soggybag/Tri-Fuzz/docs/variant_schematic.gif

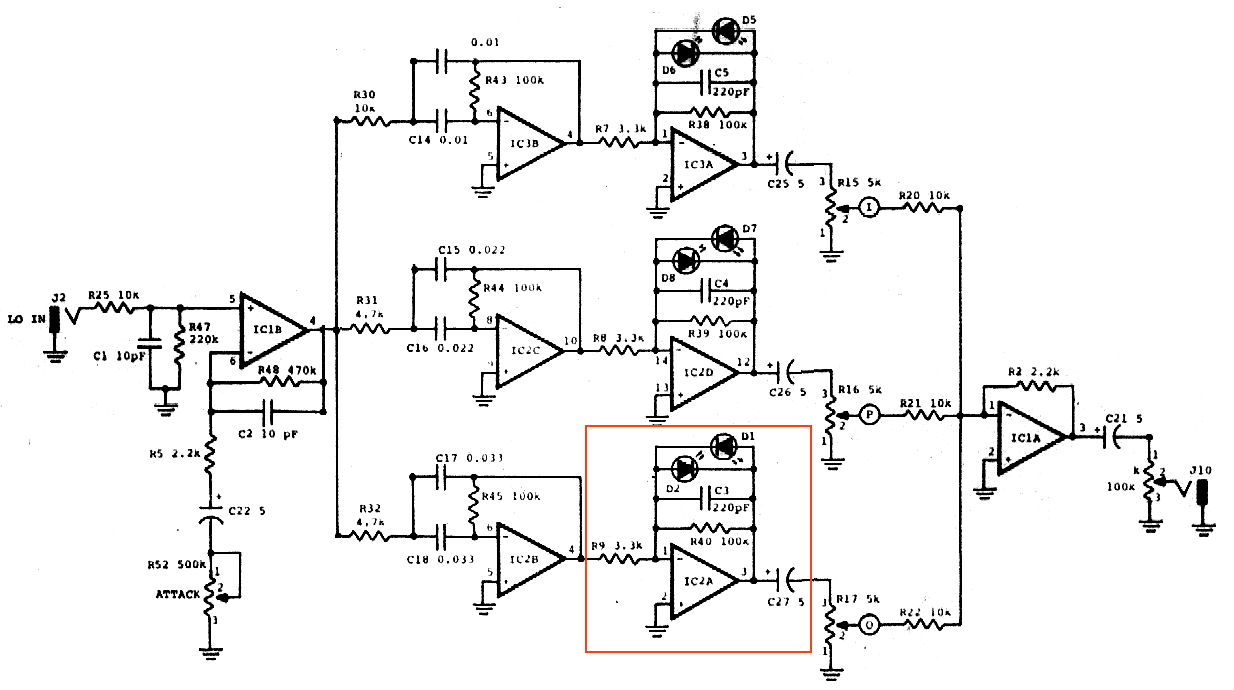
docs/variant_schematic.gif
