soggybag/Tri-Fuzz/docs/TriFuzz_schematic.pdf

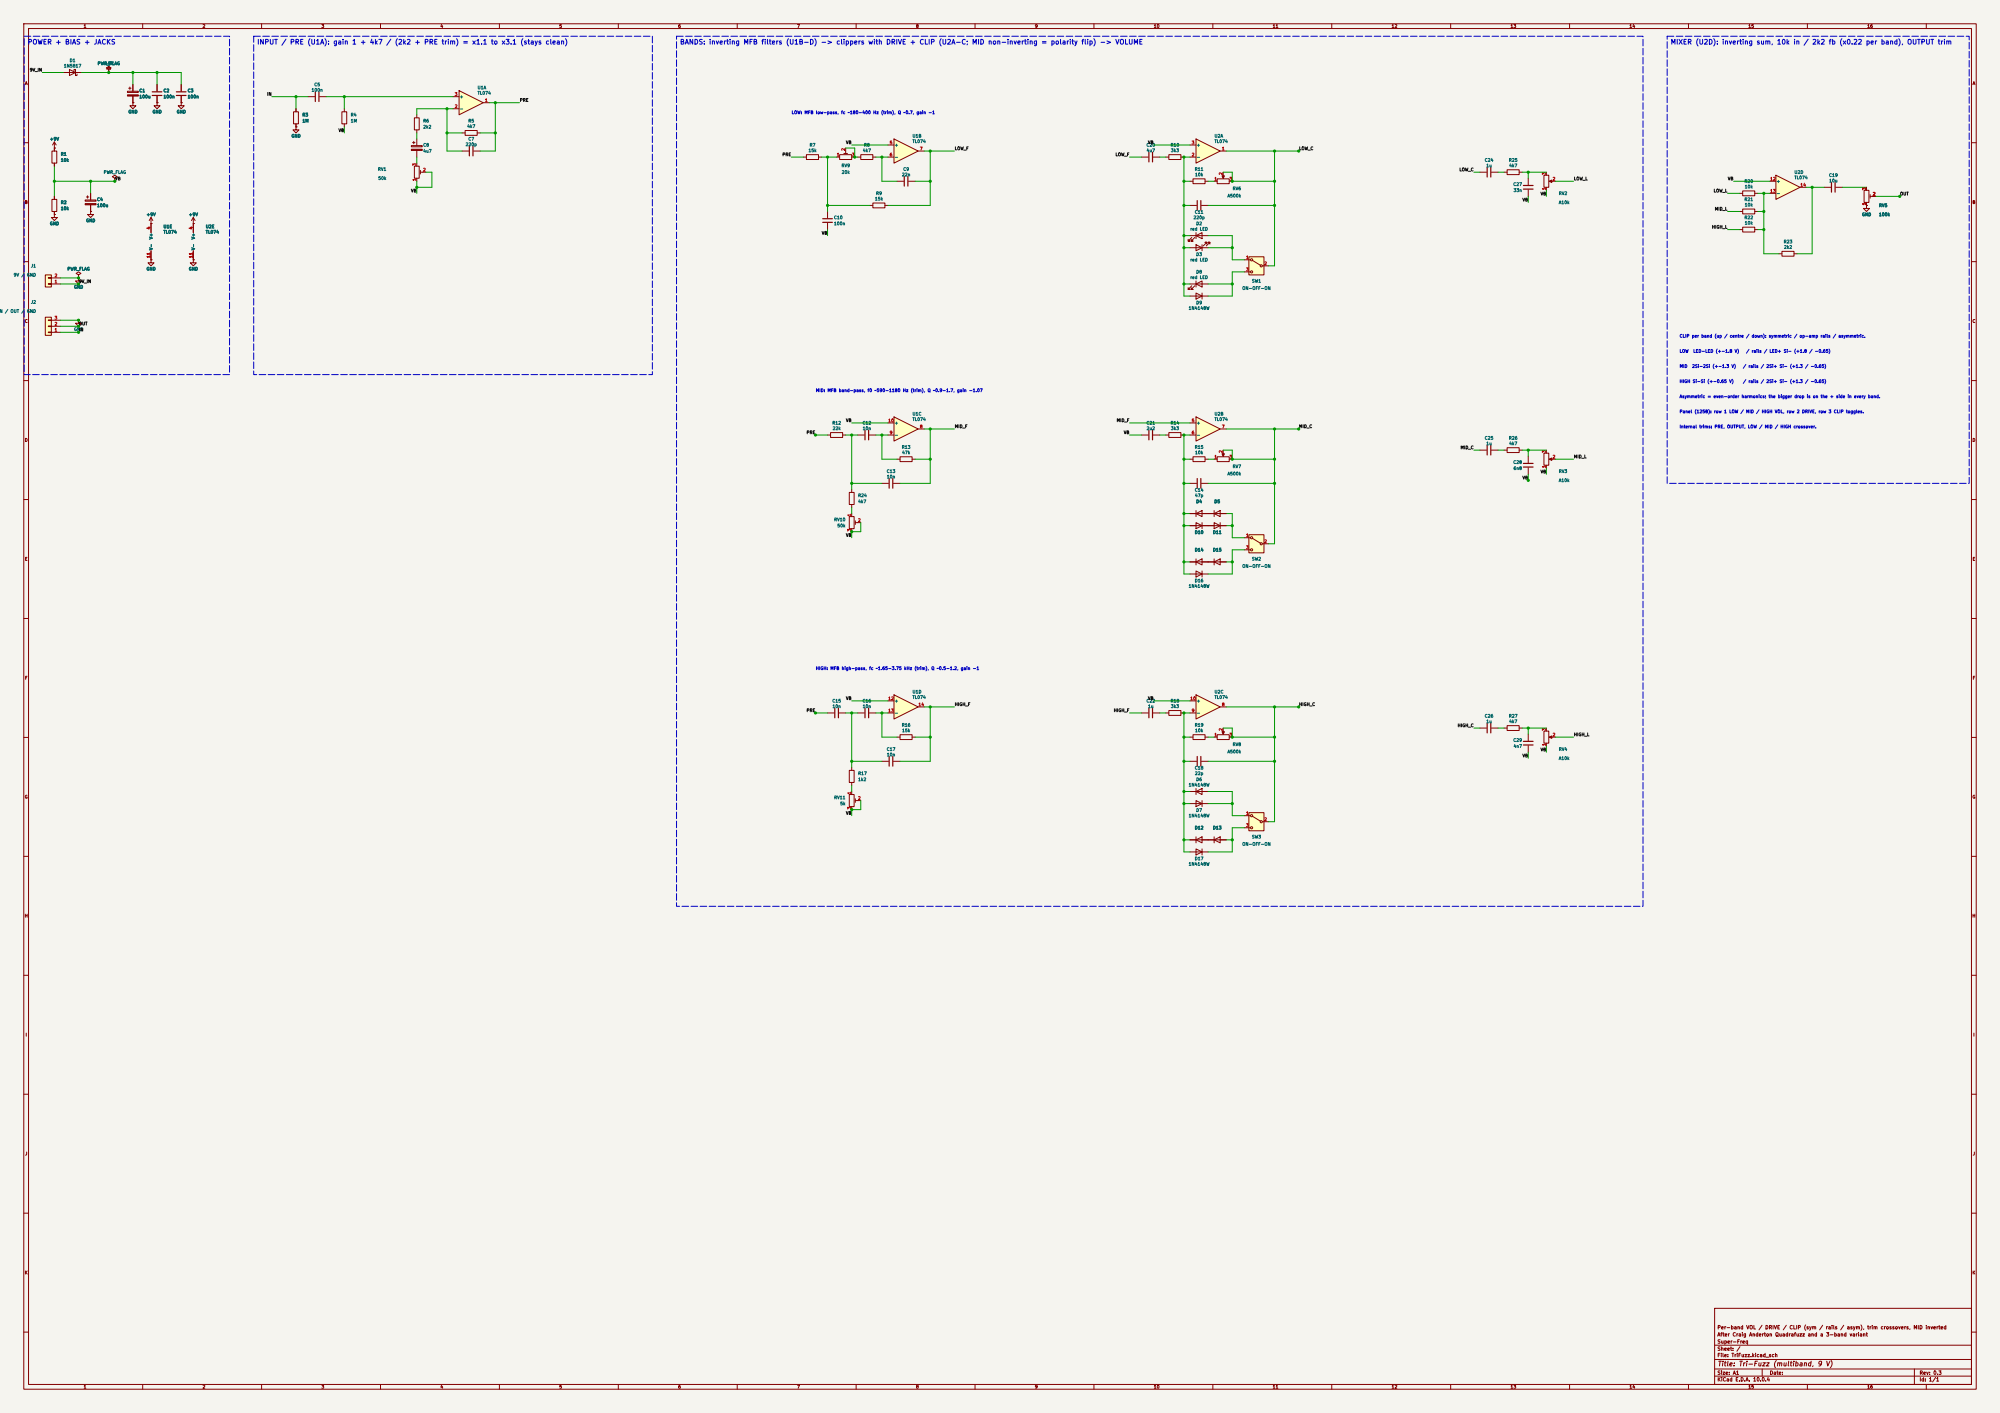
[picture p2: page 1]

BANDS: inverting MFB filters (U1B-D) -> clippers with DRIVE + CLIP (U2A-C; MID non-inverting = polarity flip) -> VOLUME

LOW: MFB low-pass, fc ~180-400 Hz (trim), Q ~0.7, gain -1

MID: MFB band-pass, f0 ~590-1180 Hz (trim), Q ~0.9-1.7, gain -1.07

Internal trims: PRE, OUTPUT, LOW / MID / HIGH crossover. Panel (125B): row 1 LOW / MID / HIGH VOL, row 2 DRIVE, row 3 CLIP toggles.

Per-band VOL / DRIVE / CLIP (sym / rails / asym), trim crossovers, MID inverted
After Craig Anderton Quadrafuzz and a 3-band variant
Super-Freq
Sheet: /
File: TriFuzz.kicad_sch
Title: Tri-Fuzz (multiband, 9 V)

Size: A1 | Rev: 0.3
KiCad E.D.A. 10.0.4 | Id: 1/1
