soggybag/Tri-Fuzz/archive/v0.1/TriFuzz_schematic_v0.1.pdf

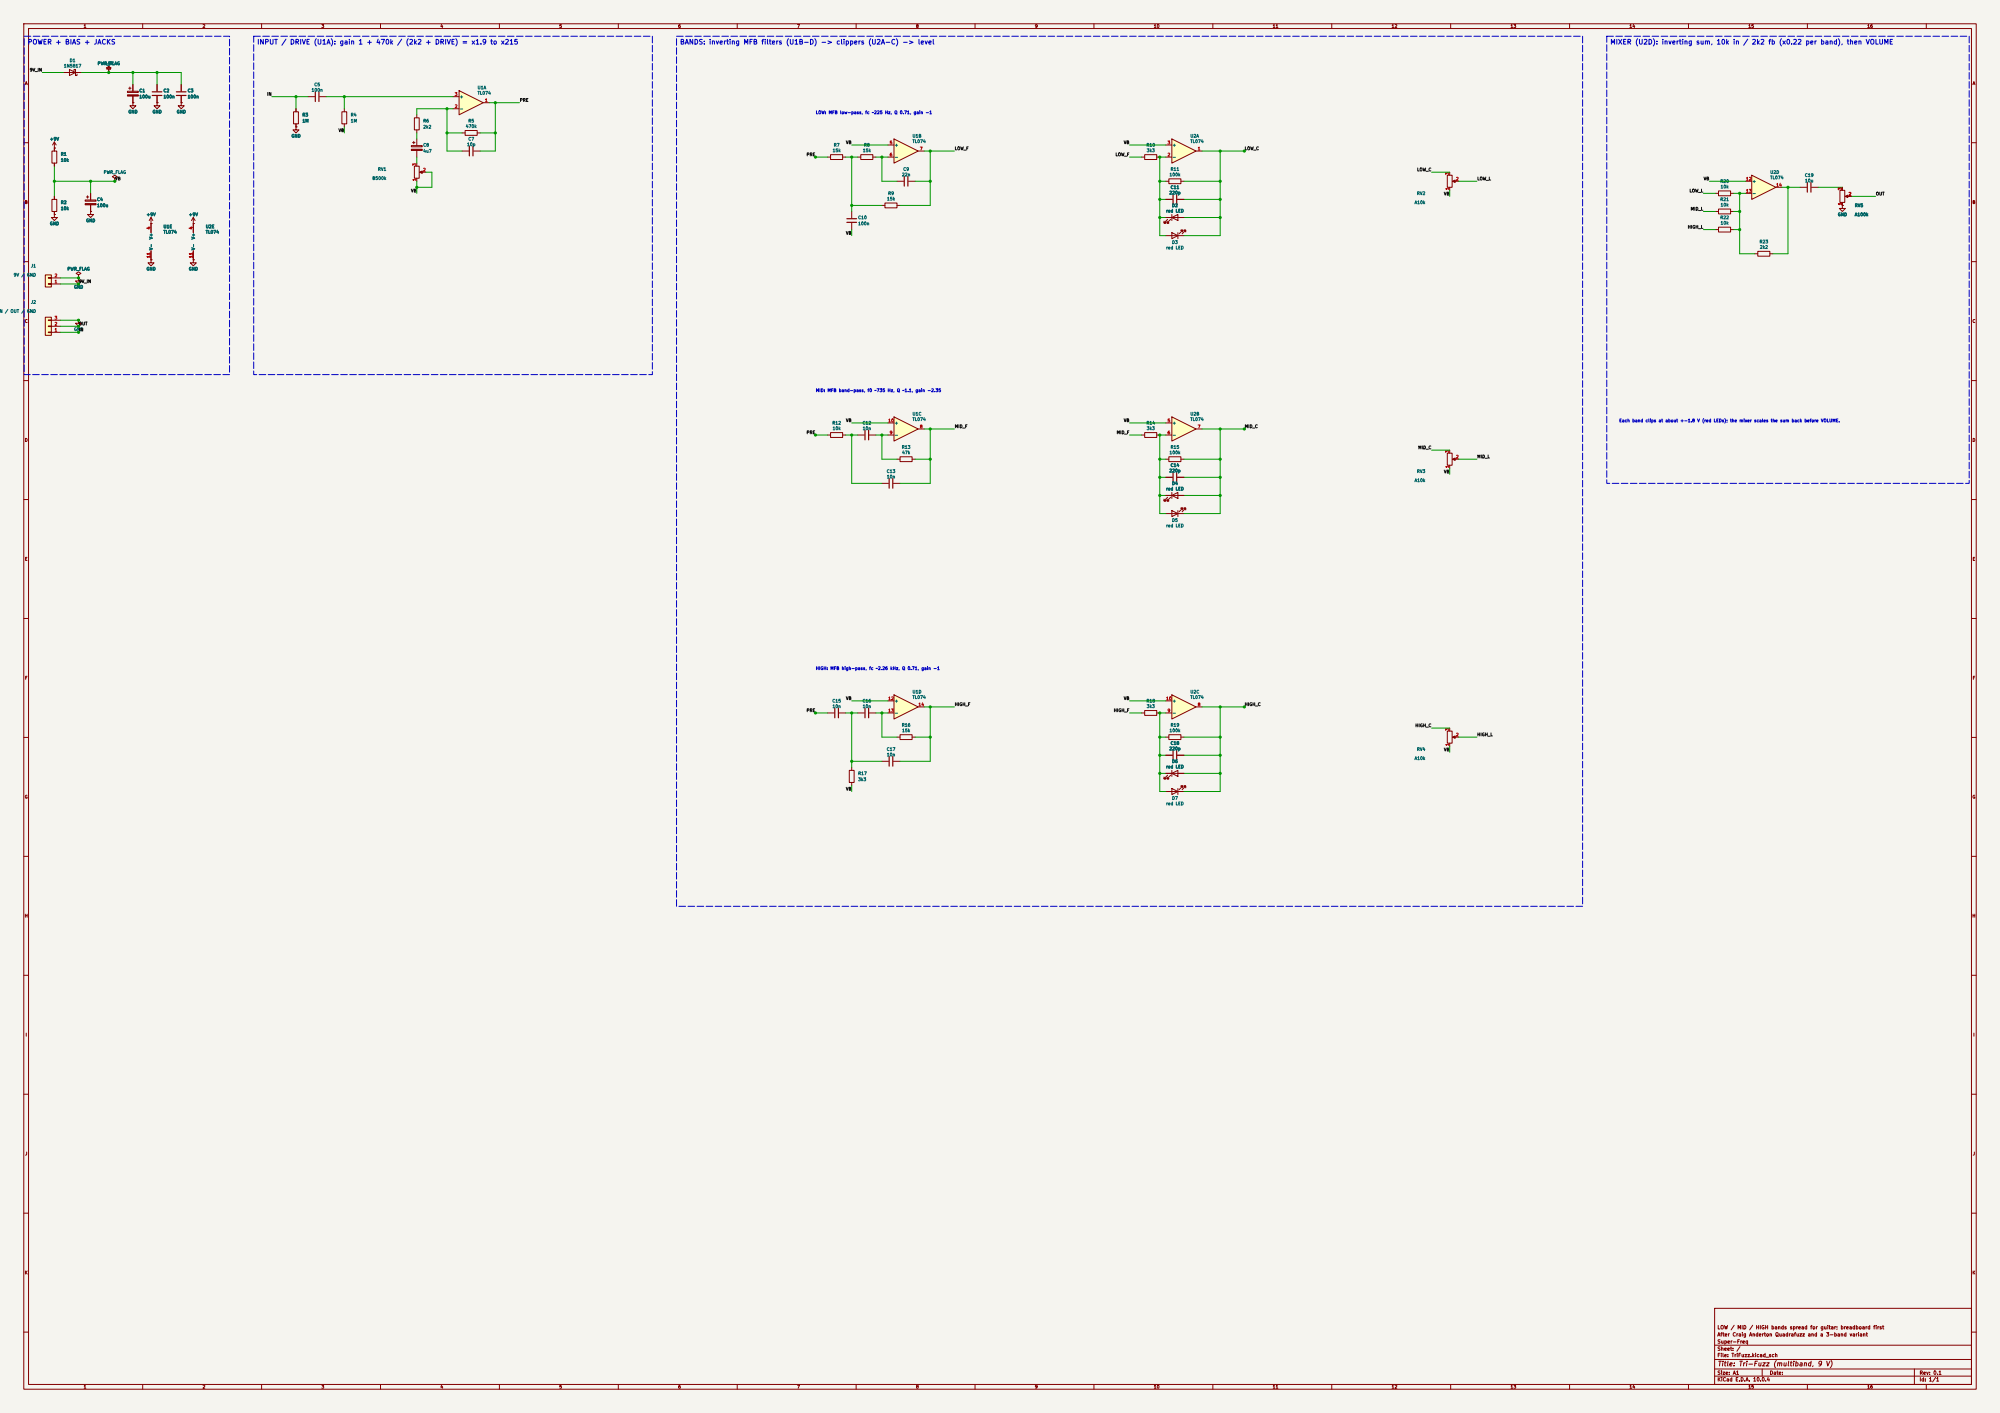
[picture p3: page 1]

INPUT / DRIVE (U1A): gain 1 + 470k / (2k2 + DRIVE) = x1.9 to x215

BANDS: inverting MFB filters (U1B-D) -> clippers (U2A-C) -> level
LOW: MFB low-pass, fc ~225 Hz, Q 0.71, gain -1 MID: MFB band-pass, f0 ~735 Hz, Q ~1.1, gain -2.35

Each band clips at about +-1.8 V (red LEDs); the mixer scales the sum back before VOLUME. MIXER (U2D): inverting sum, 10k in / 2k2 fb (x0.22 per band), then VOLUME

HIGH: MFB high-pass, fc ~2.26 kHz, Q 0.71, gain -1

LOW / MID / HIGH bands spread for guitar; breadboard first
After Craig Anderton Quadrafuzz and a 3-band variant
Super-Freq
Sheet: /
File: TriFuzz.kicad_sch
Title: Tri-Fuzz (multiband, 9 V)

Size: A1 | Rev: 0.1
KiCad E.D.A. 10.0.4 | Id: 1/1
