soggybag/Tri-Fuzz/archive/v0.2/TriFuzz_schematic_v0.2.pdf

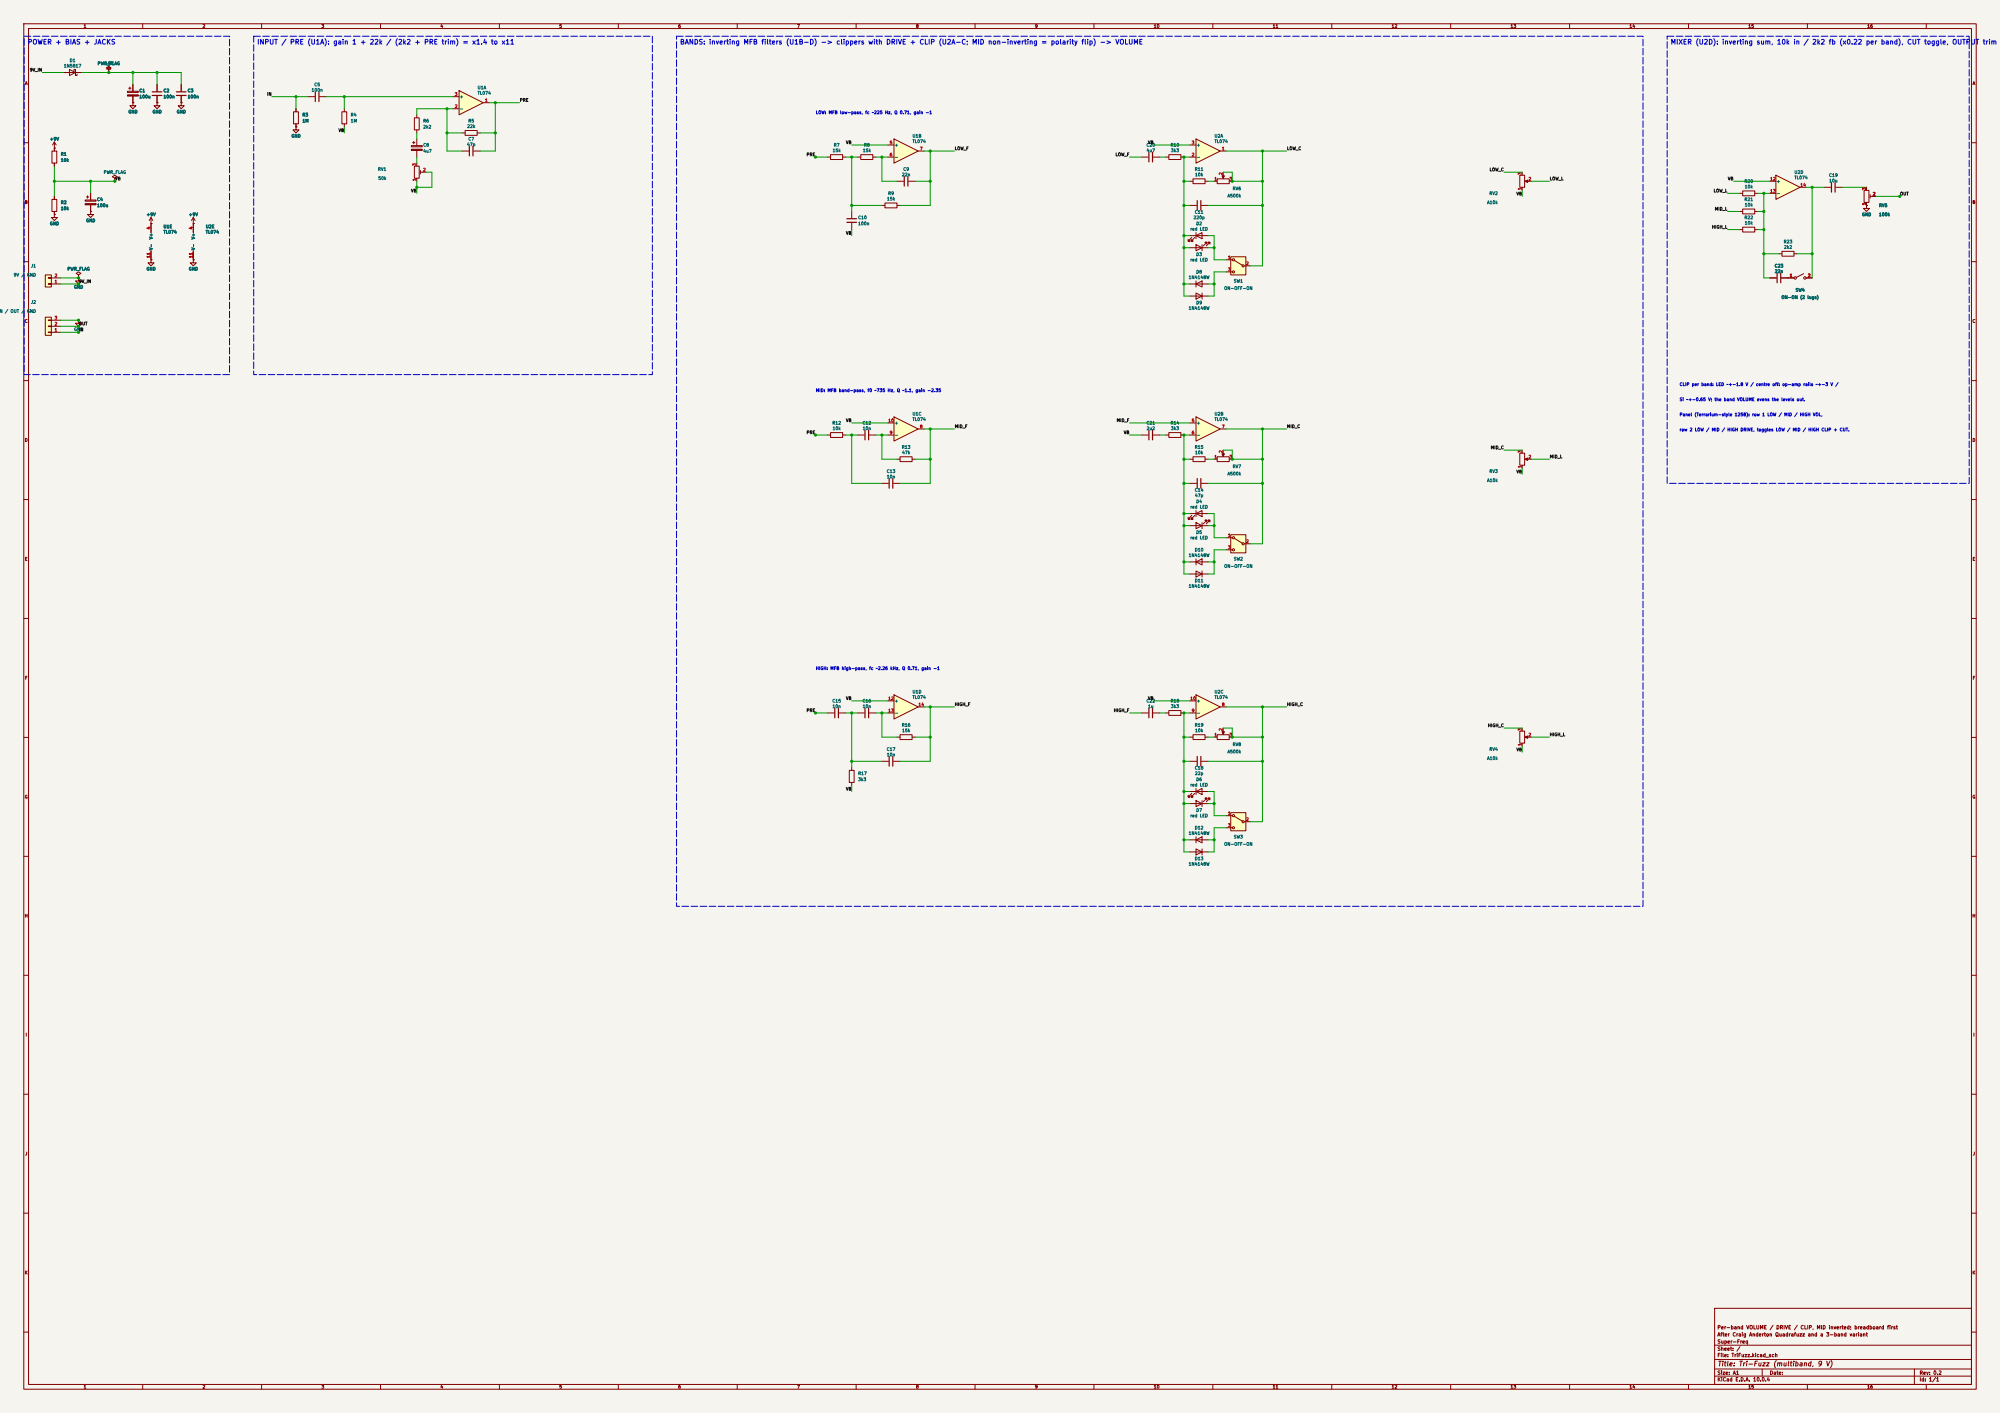
[picture p4: page 1]
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

LOW: MFB low-pass, fc ~225 Hz, Q 0.71, gain -1

CLIP per band: LED ~+-1.8 V / centre off: op-amp rails ~+-3 V /

MID: MFB band-pass, f0 ~735 Hz, Q ~1.1, gain -2.35

row 2 LOW / MID / HIGH DRIVE, toggles LOW / MID / HIGH CLIP + CUT. Panel (Terrarium-style 125B): row 1 LOW / MID / HIGH VOL, Si ~+-0.65 V; the band VOLUME evens the levels out.

HIGH: MFB high-pass, fc ~2.26 kHz, Q 0.71, gain -1

Per-band VOLUME / DRIVE / CLIP, MID inverted; breadboard first
After Craig Anderton Quadrafuzz and a 3-band variant
Super-Freq
Sheet: /
File: TriFuzz.kicad_sch
Title: Tri-Fuzz (multiband, 9 V)

Size: A1 | Rev: 0.2
KiCad E.D.A. 10.0.4 | Id: 1/1
