soggybag/Tri-Fuzz/TriFuzz.kicad_sch

## KiCad design TriFuzz.kicad_sch (2026-10-17)

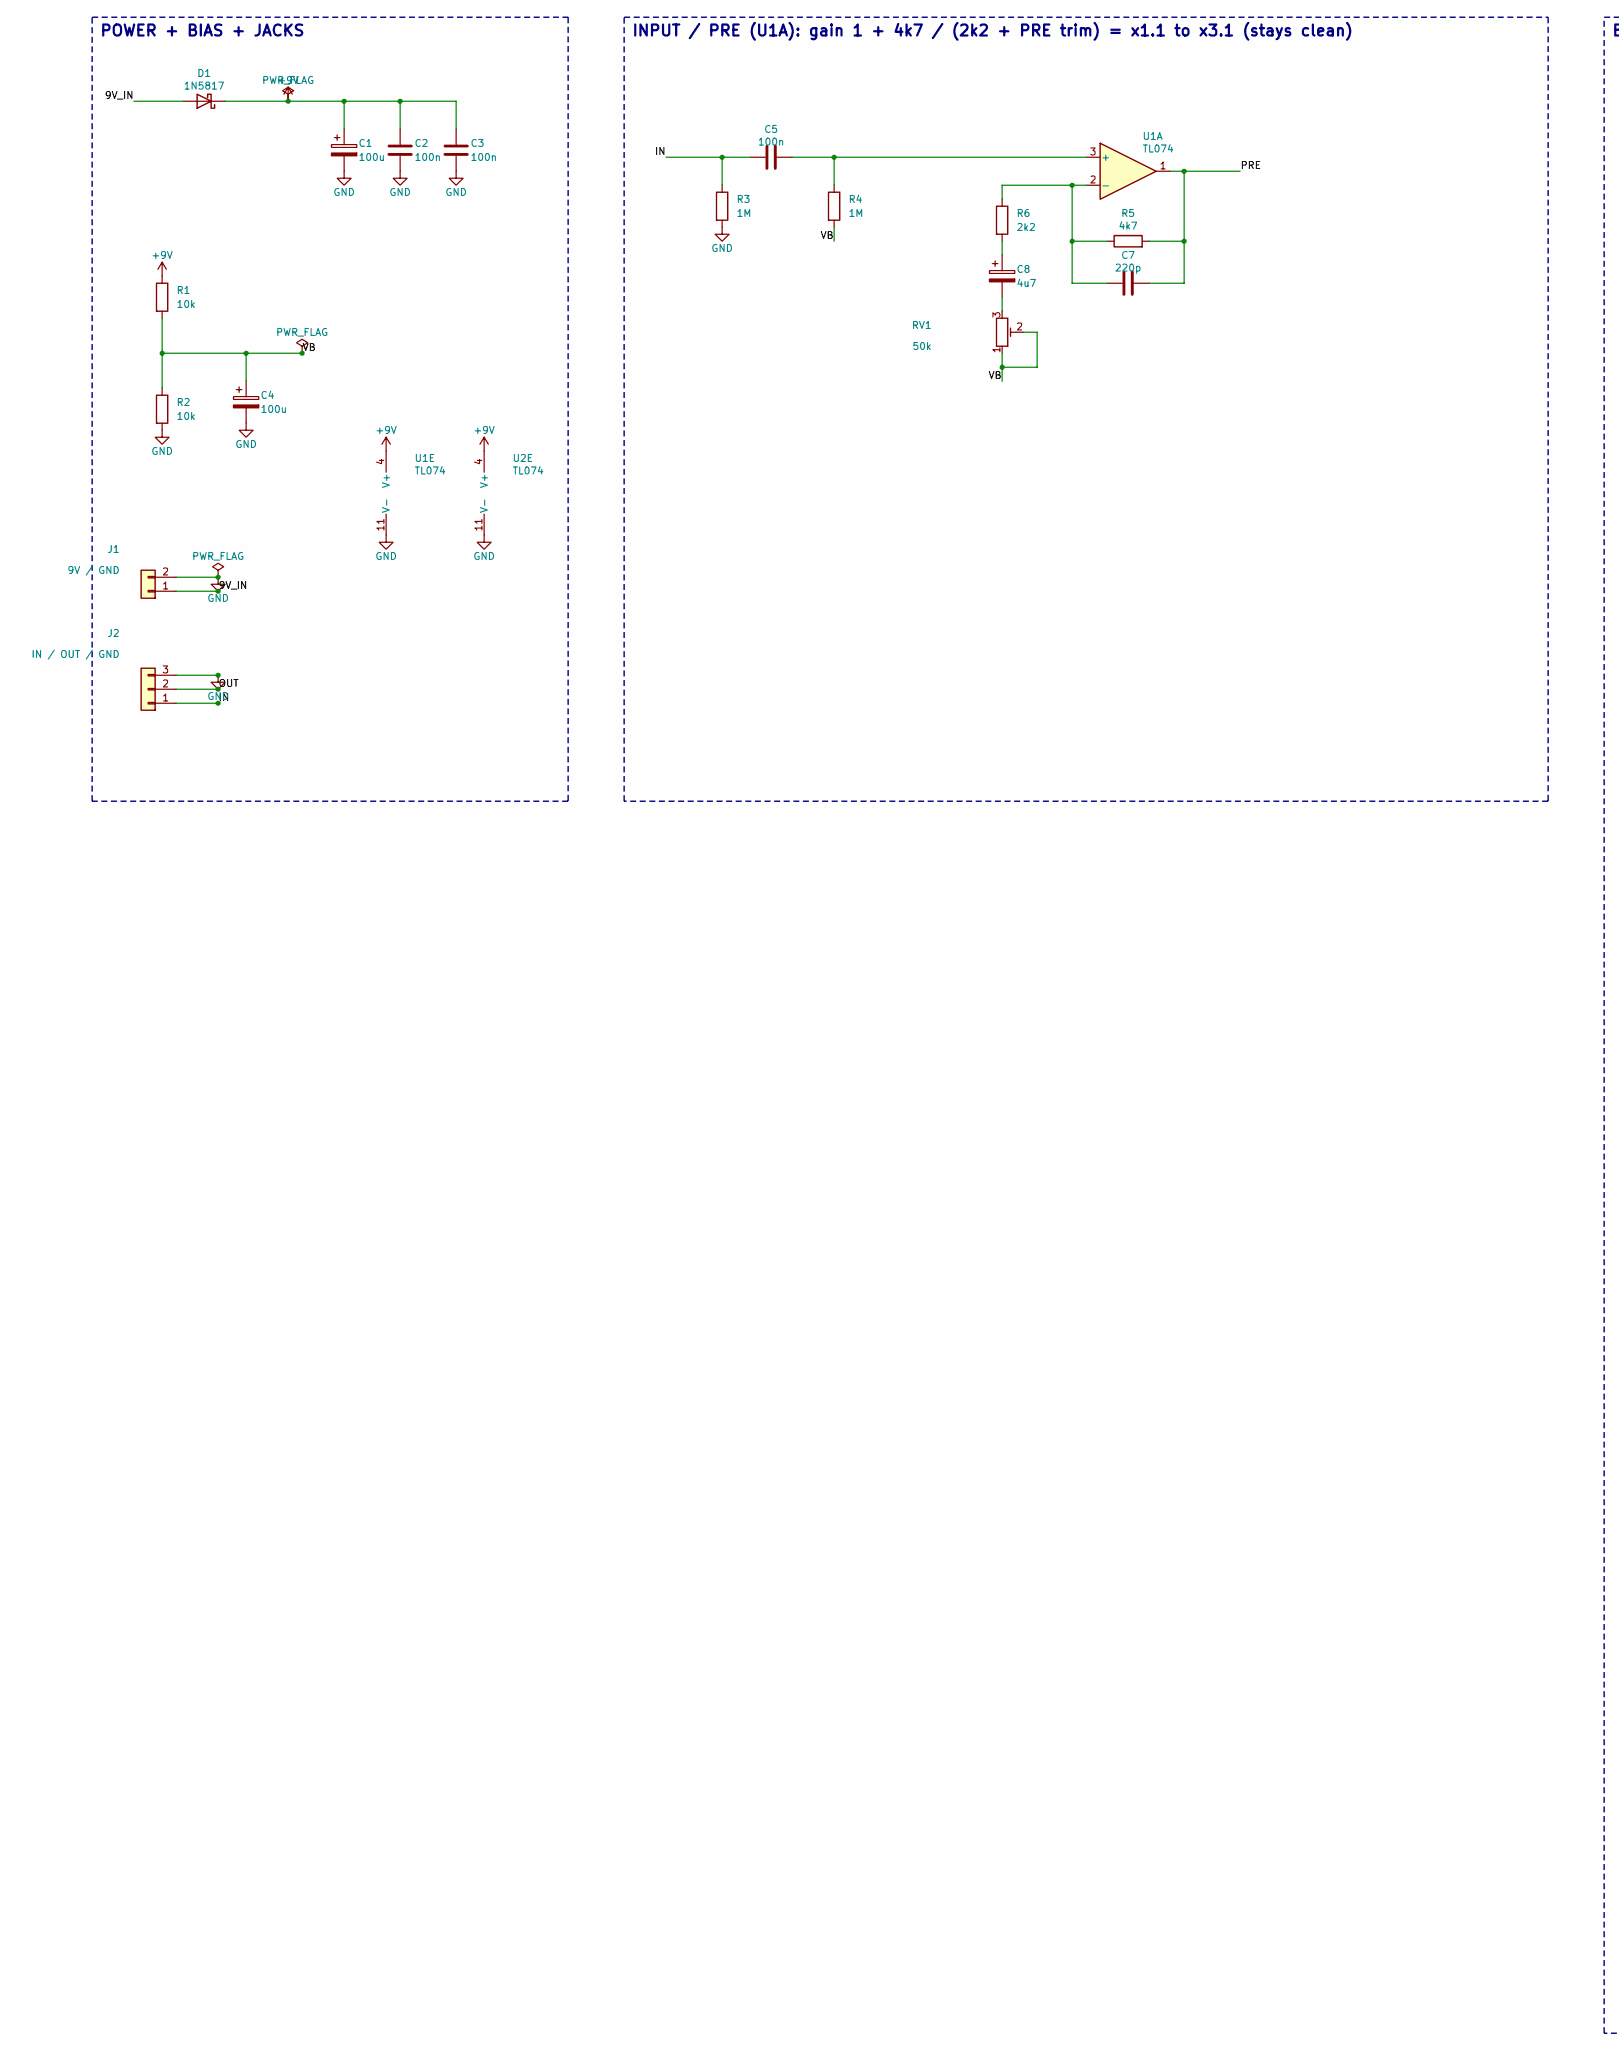
[picture p5: schematic TriFuzz.kicad_sch, part in row 1, column 1]

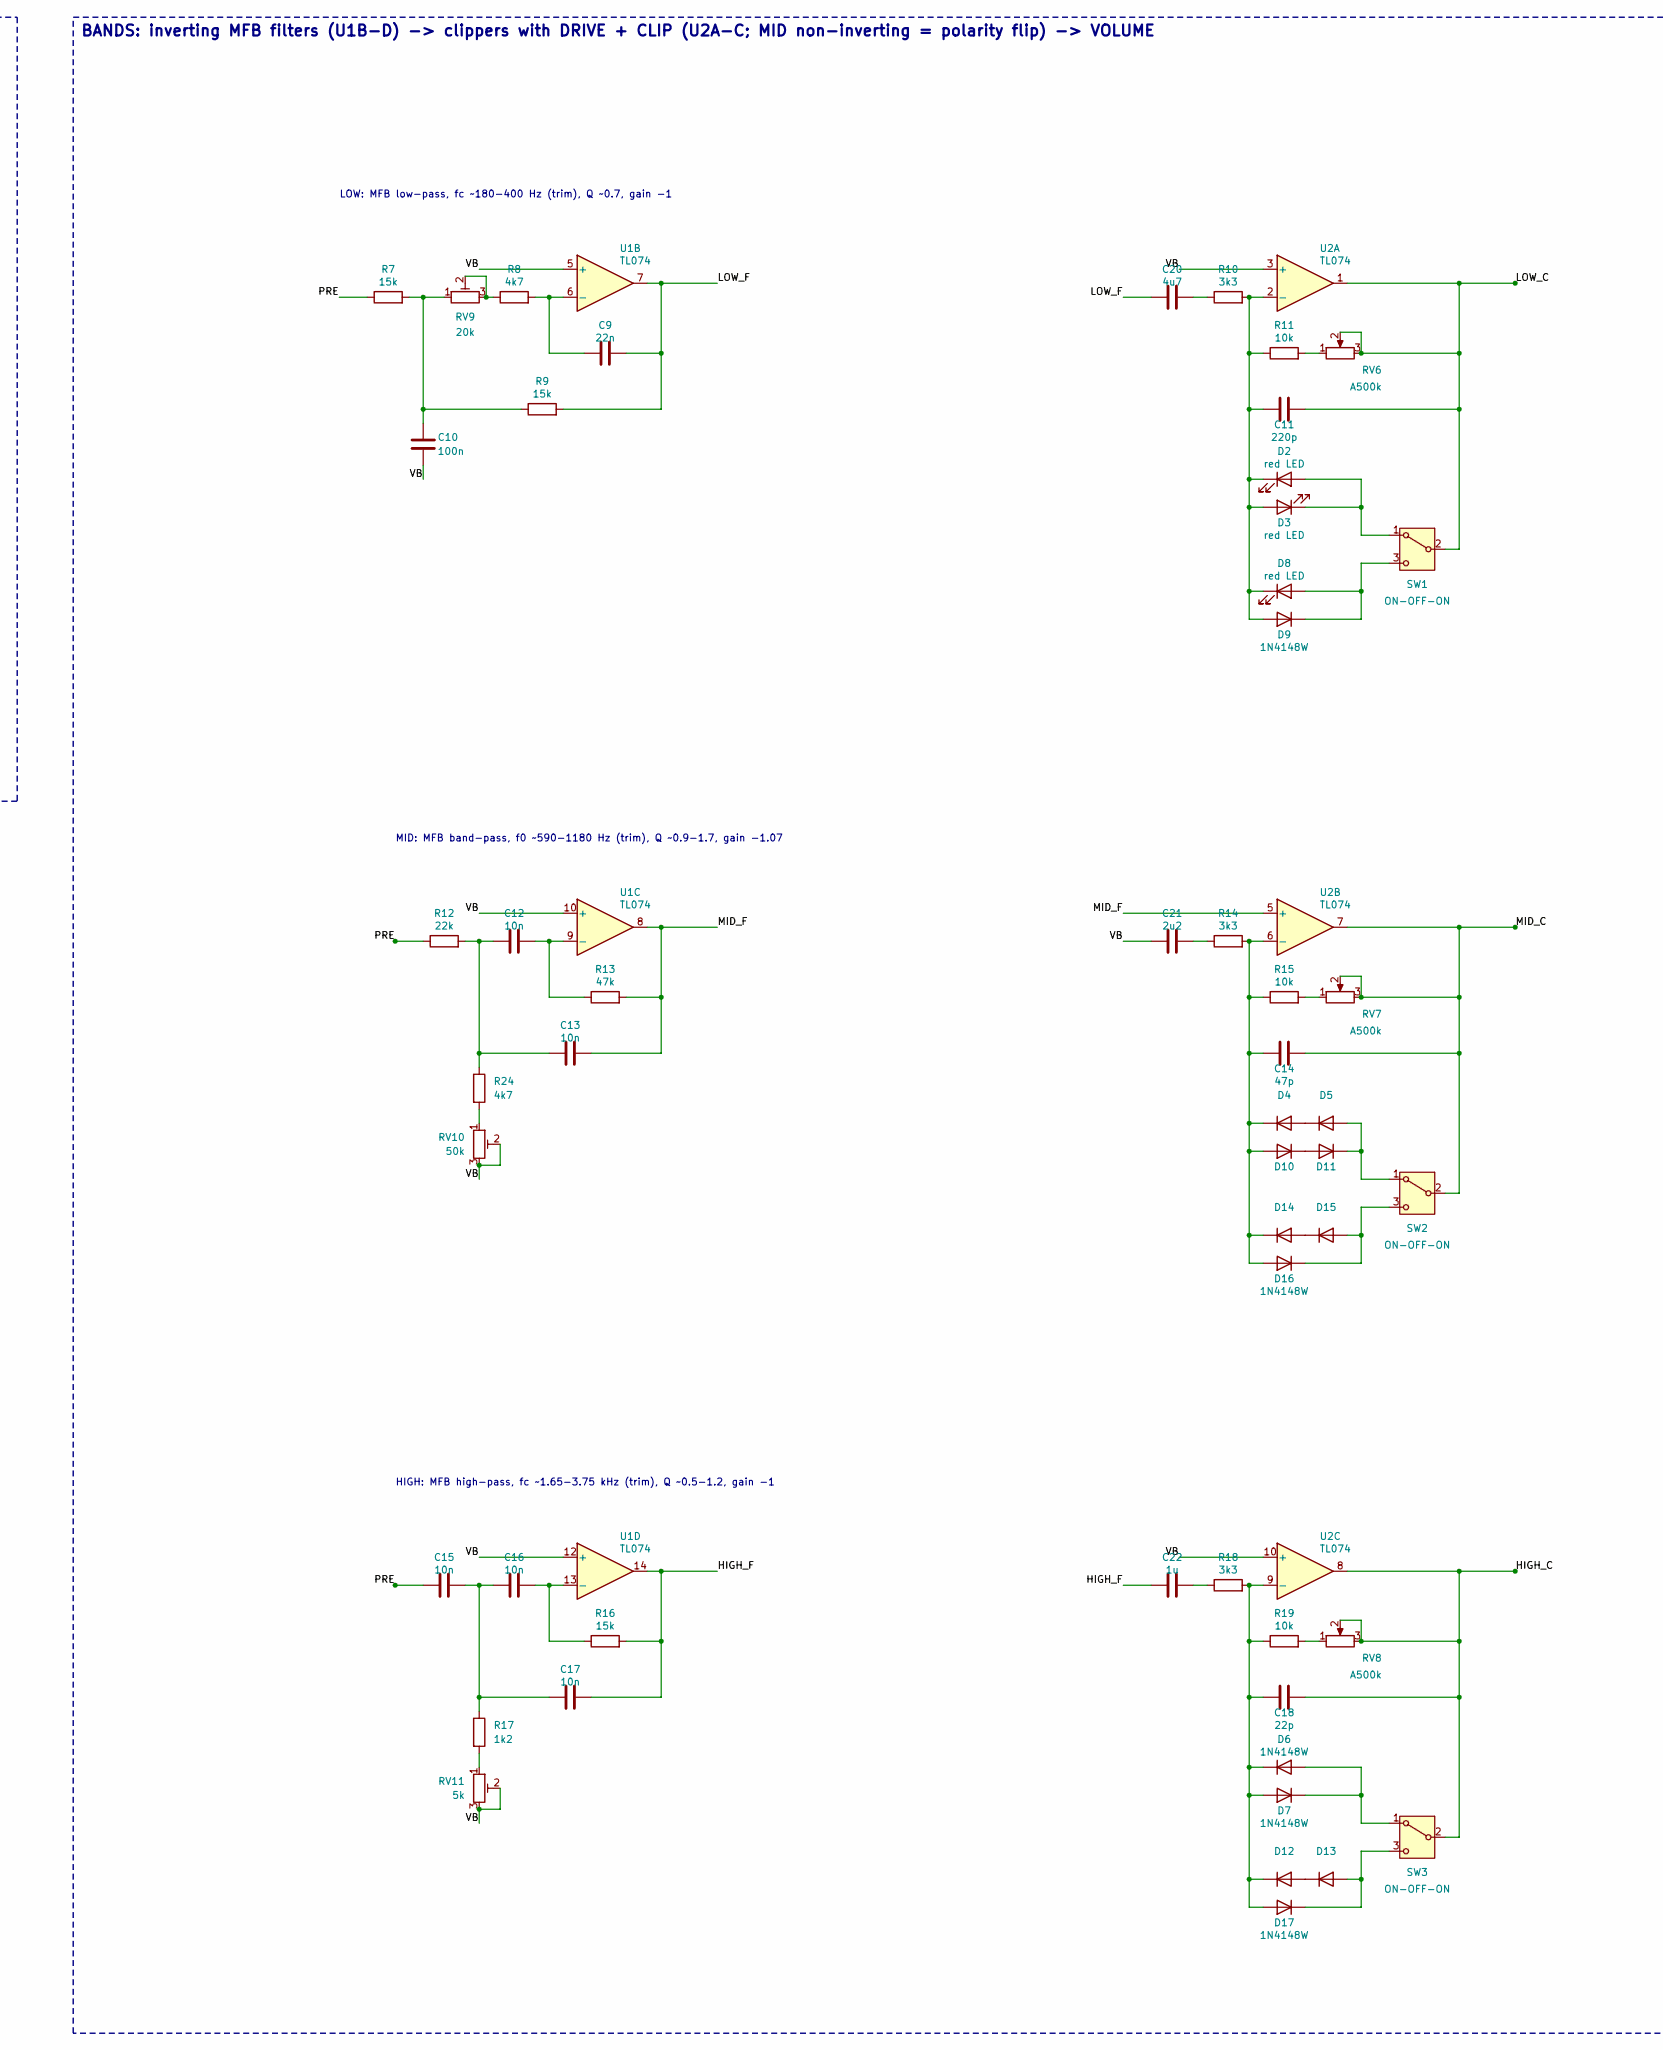
[picture p6: schematic TriFuzz.kicad_sch, part in row 1, column 2]

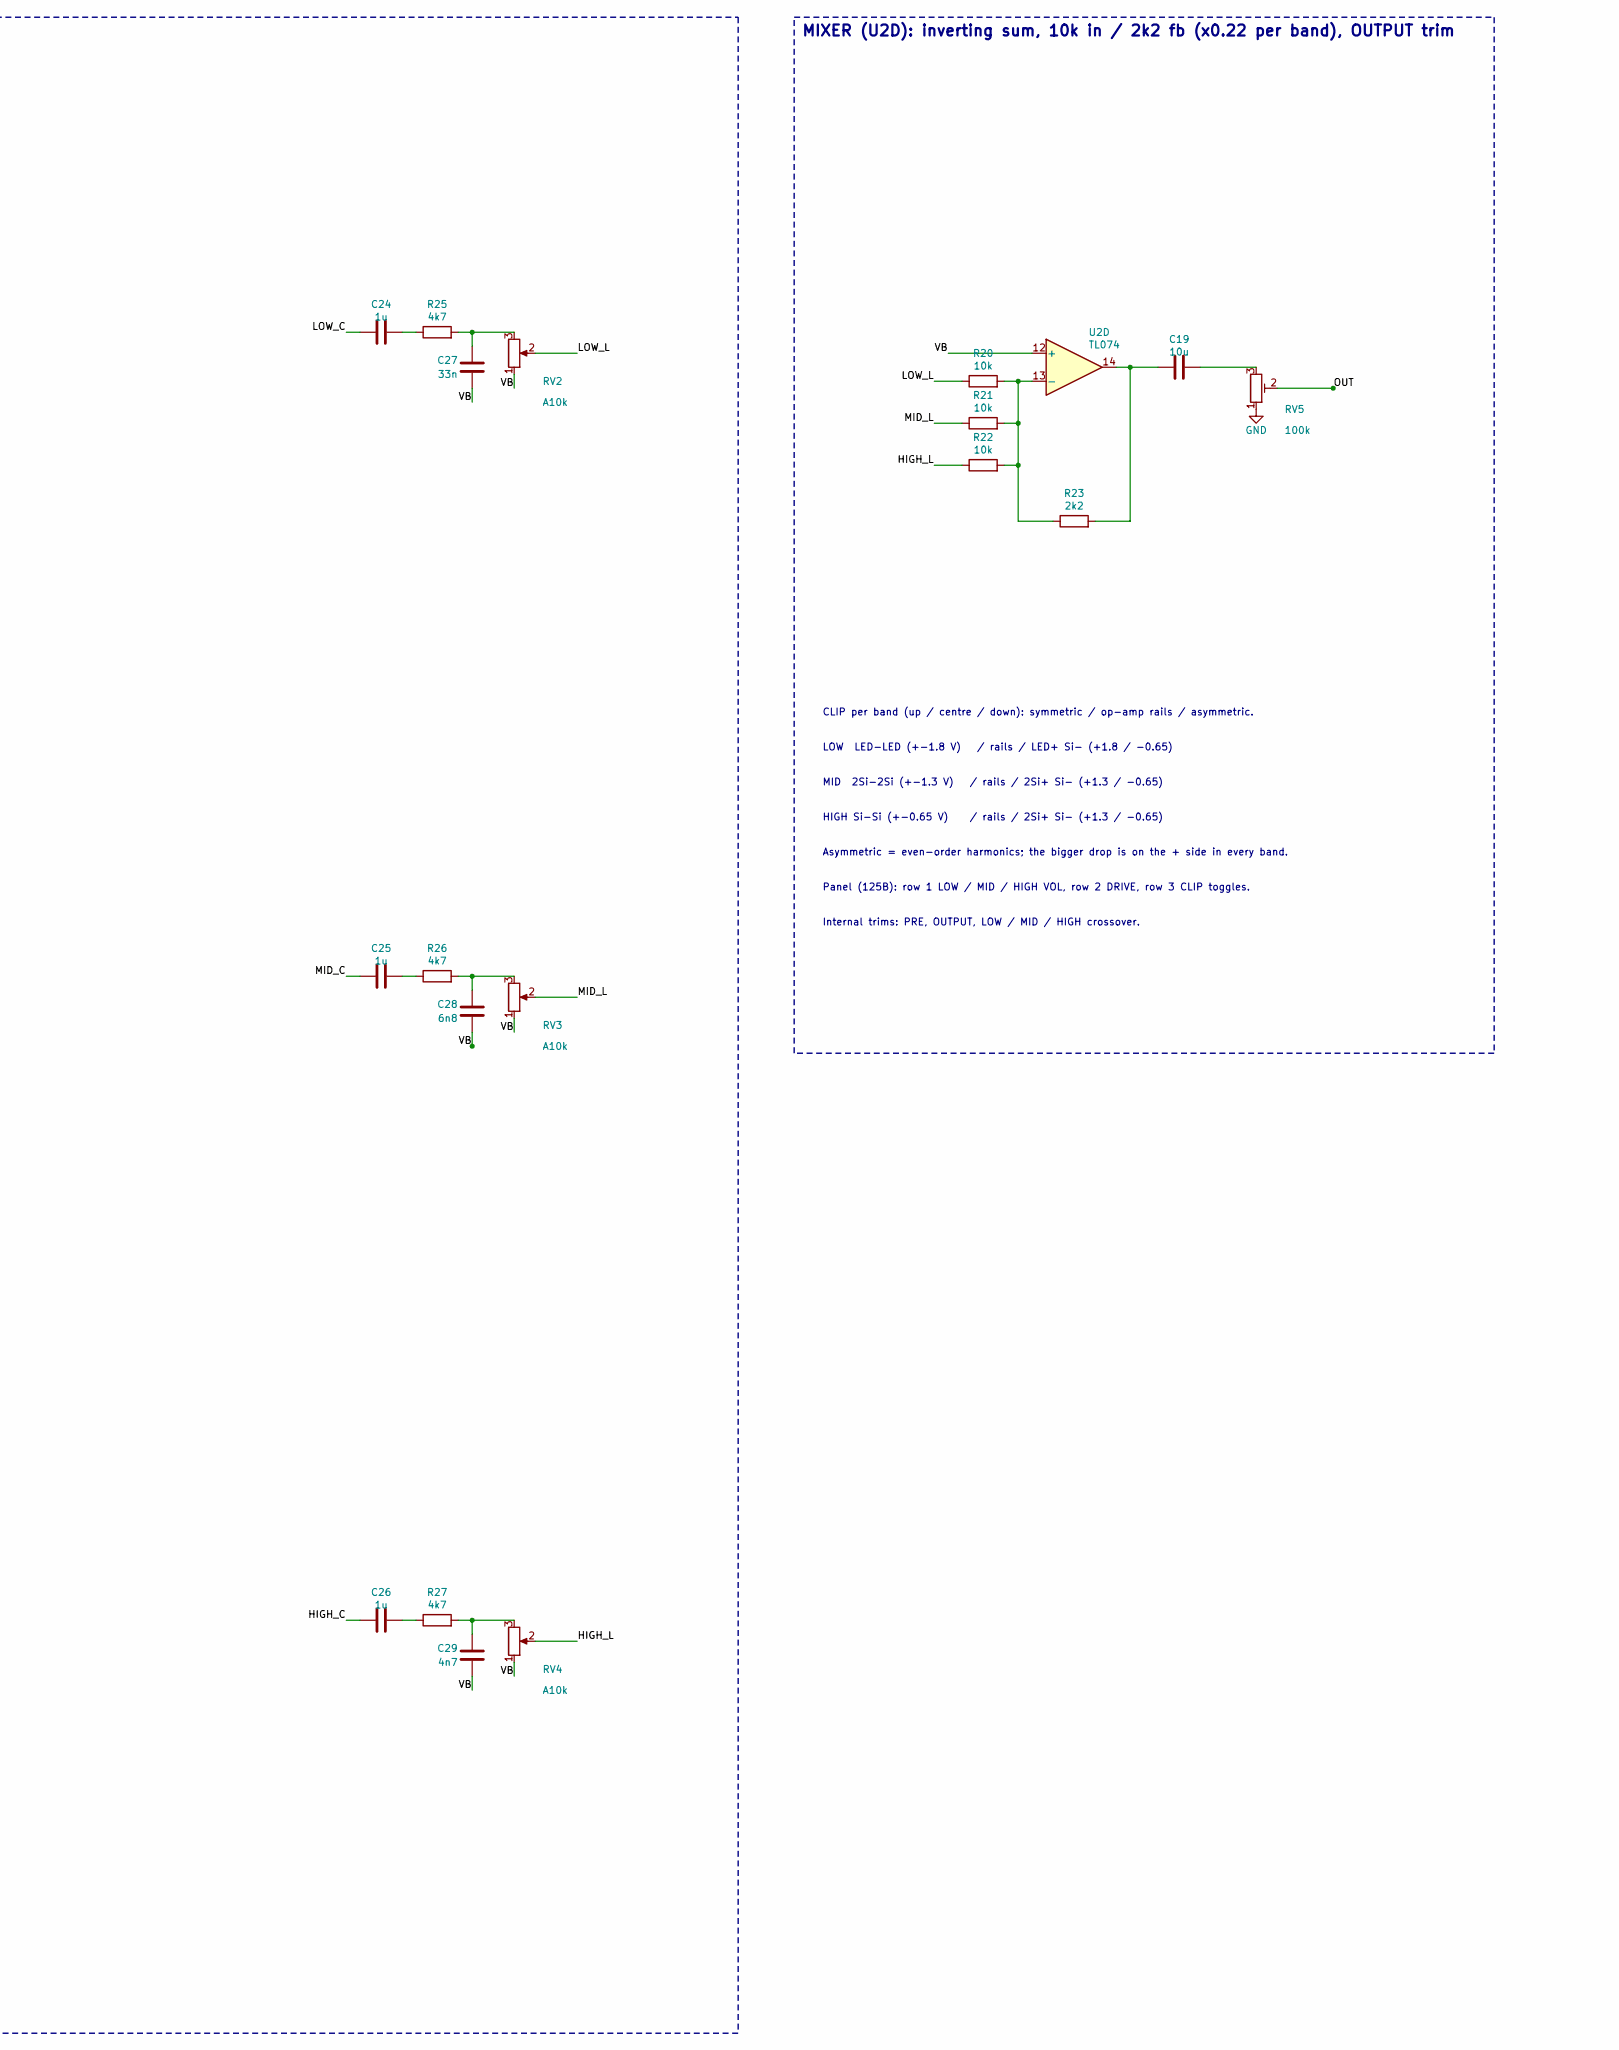
[picture p7: schematic TriFuzz.kicad_sch, part in row 1, column 3]

Parts:
C1, C4: 100u
C2, C3, C5, C10: 100n
C7, C11: 220p
C8, C20: 4u7
C9: 22n
C12, C13, C15, C16, C17: 10n
C14: 47p
C18: 22p
C19: 10u
C21: 2u2
C22, C24, C25, C26: 1u
C27: 33n
C28: 6n8
C29: 4n7
D1: 1N5817
D2, D3, D8: red LED
D4, D5, D6, D7, D9, D10, D11, D12, D13, D14, D15, D16, D17: 1N4148W
J1: 9V / GND
J2: IN / OUT / GND
R1, R2, R11, R15, R19, R20, R21, R22: 10k
R3, R4: 1M
R5, R8, R24, R25, R26, R27: 4k7
R6, R23: 2k2
R7, R9, R16: 15k
R10, R14, R18: 3k3
R12: 22k
R13: 47k
R17: 1k2
RV1, RV10: 50k
RV2, RV3, RV4: A10k
RV5: 100k
RV6, RV7, RV8: A500k
RV9: 20k
RV11: 5k
SW1, SW2, SW3: ON-OFF-ON
U1, U2: TL074

Connections:
9V_IN: D1.2 (A), J1.1
+9V: C1.1, C1.2, C2.1, C2.2, C3.1, C3.2, C4.1, C4.2, C10.2, C21.1, C27.2, C28.2, C29.2, D1.1 (K), J1.2, J2.3, R1.1, R1.2, R2.1, R2.2, R3.2, R4.2, RV1.1, RV1.2, RV2.1, RV3.1, RV4.1, RV5.1, RV10.2, RV10.3, RV11.2, RV11.3, U1.4 (V+), U1.5 (+), U1.10 (+), U1.11 (V-), U1.12 (+), U2.3 (+), U2.4 (V+), U2.10 (+), U2.11 (V-), U2.12 (+)
HIGH_C: C18.2, C26.1, RV8.2, RV8.3, SW3.2 (B), U2.8
HIGH_F: C17.2, C22.1, R16.2, U1.14
HIGH_L: R22.1, RV4.2
IN: C5.1, J2.1, R3.1
LOW_C: C11.2, C24.1, RV6.2, RV6.3, SW1.2 (B), U2.1
LOW_F: C9.2, C20.1, R9.2, U1.7
LOW_L: R20.1, RV2.2
MID_C: C14.2, C25.1, RV7.2, RV7.3, SW2.2 (B), U2.7
MID_F: C13.2, R13.2, U1.8, U2.5 (+)
MID_L: R21.1, RV3.2
unnamed: C5.2, R4.1, U1.3 (+)
unnamed: C7.1, R5.1, R6.1, U1.2 (-)
unnamed: C8.1, R6.2
unnamed: C8.2, RV1.3
unnamed: C9.1, R8.2, U1.6 (-)
unnamed: C10.1, R7.2, R9.1, RV9.1
unnamed: C11.1, D2.1 (K), D3.2 (A), D8.1 (K), D9.2 (A), R10.2, R11.1, U2.2 (-)
unnamed: C12.1, C13.1, R12.2, R24.1
unnamed: C12.2, R13.1, U1.9 (-)
unnamed: C14.1, D4.1 (K), D10.2 (A), D14.1 (K), D16.2 (A), R14.2, R15.1, U2.6 (-)
unnamed: C15.2, C16.1, C17.1, R17.1
unnamed: C16.2, R16.1, U1.13 (-)
unnamed: C18.1, D6.1 (K), D7.2 (A), D12.1 (K), D17.2 (A), R18.2, R19.1, U2.9 (-)
unnamed: C19.1, R23.2, U2.14
unnamed: C19.2, RV5.3
unnamed: C20.2, R10.1
unnamed: C21.2, R14.1
unnamed: C22.2, R18.1
unnamed: C24.2, R25.1
unnamed: C25.2, R26.1
unnamed: C26.2, R27.1
unnamed: C27.1, R25.2, RV2.3
unnamed: C28.1, R26.2, RV3.3
unnamed: C29.1, R27.2, RV4.3
unnamed: D2.2 (A), D3.1 (K), SW1.1 (A)
unnamed: D4.2 (A), D5.1 (K)
unnamed: D6.2 (A), D7.1 (K), SW3.1 (A)
unnamed: D8.2 (A), D9.1 (K), SW1.3 (C)
unnamed: D10.1 (K), D11.2 (A)
unnamed: D5.2 (A), D11.1 (K), SW2.1 (A)
unnamed: D12.2 (A), D13.1 (K)
unnamed: D13.2 (A), D17.1 (K), SW3.3 (C)
unnamed: D14.2 (A), D15.1 (K)
unnamed: D15.2 (A), D16.1 (K), SW2.3 (C)
unnamed: R8.1, RV9.2, RV9.3
unnamed: R11.2, RV6.1
unnamed: R15.2, RV7.1
unnamed: R17.2, RV11.1
unnamed: R19.2, RV8.1
unnamed: R20.2, R21.2, R22.2, R23.1, U2.13 (-)
unnamed: R24.2, RV10.1
OUT: J2.2, RV5.2
PRE: C7.2, C15.1, R5.2, R7.1, R12.1, U1.1

Notes on the sheet:
POWER + BIAS + JACKS
INPUT / PRE (U1A): gain 1 + 4k7 / (2k2 + PRE trim) = x1.1 to x3.1 (stays clean)
BANDS: inverting MFB filters (U1B-D) -> clippers with DRIVE + CLIP (U2A-C; MID non-inverting = polarity flip) -> VOLUME
LOW: MFB low-pass, fc ~180-400 Hz (trim), Q ~0.7, gain -1
MID: MFB band-pass, f0 ~590-1180 Hz (trim), Q ~0.9-1.7, gain -1.07
HIGH: MFB high-pass, fc ~1.65-3.75 kHz (trim), Q ~0.5-1.2, gain -1
MIXER (U2D): inverting sum, 10k in / 2k2 fb (x0.22 per band), OUTPUT trim
CLIP per band (up / centre / down): symmetric / op-amp rails / asymmetric.
LOW LED-LED (+-1.8 V) / rails / LED+ Si- (+1.8 / -0.65)
MID 2Si-2Si (+-1.3 V) / rails / 2Si+ Si- (+1.3 / -0.65)
HIGH Si-Si (+-0.65 V) / rails / 2Si+ Si- (+1.3 / -0.65)
Asymmetric = even-order harmonics; the bigger drop is on the + side in every band.
Panel (125B): row 1 LOW / MID / HIGH VOL, row 2 DRIVE, row 3 CLIP toggles.
Internal trims: PRE, OUTPUT, LOW / MID / HIGH crossover.
